jordanbyron/gb-proton-pack/docs/bargraph/Screenshot 2023-05-10 at 12.45.05 PM.png

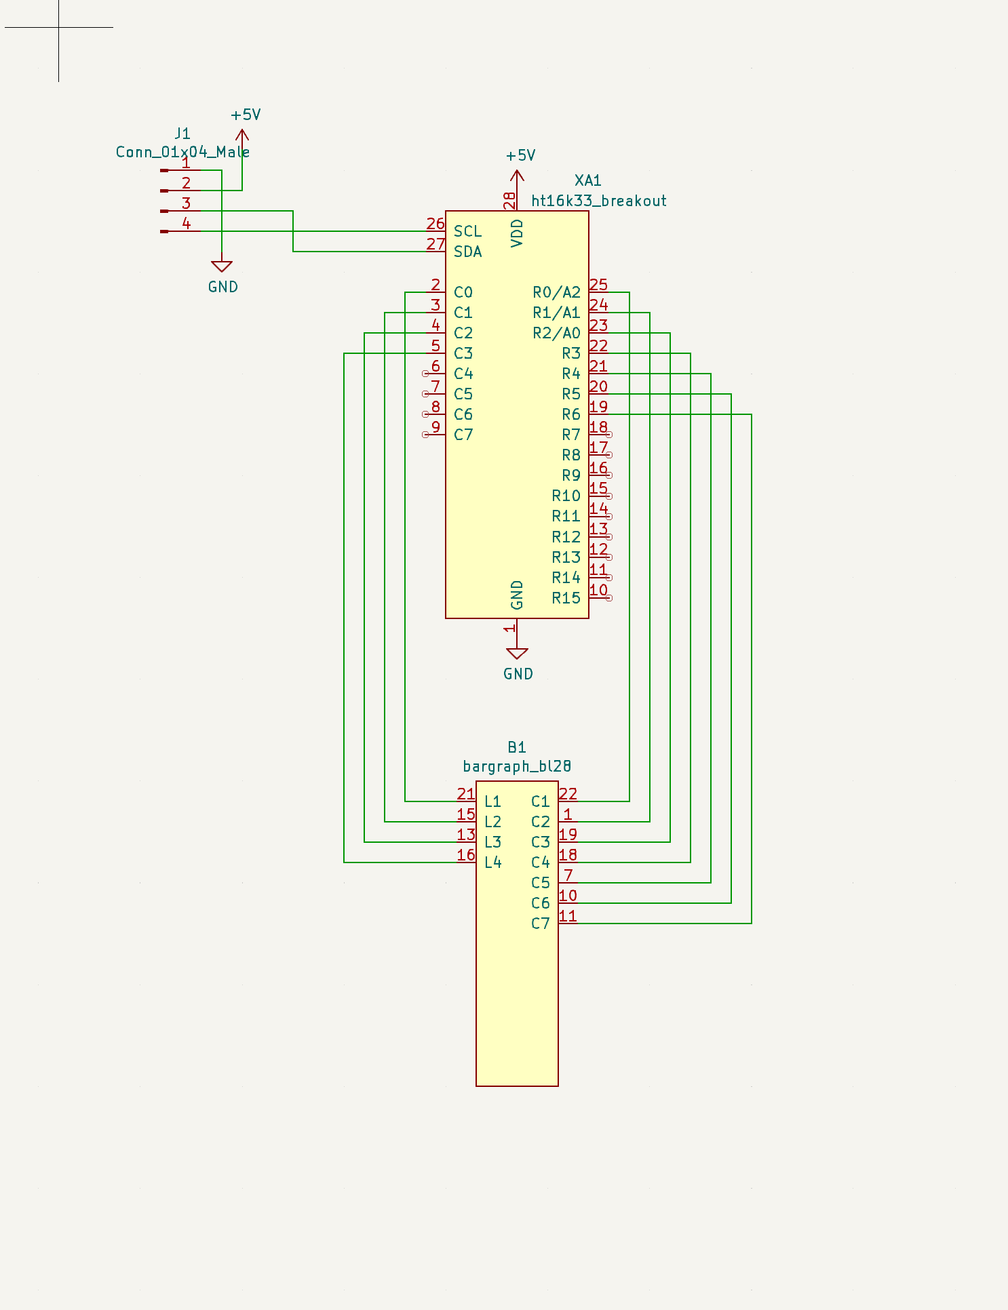
docs/bargraph/Screenshot 2023-05-10 at 12.45.05 PM.png
