jordanbyron/gb-proton-pack/(commit log)

2026-09-20 fix: Cycle smoke vape pen on / off
    [MainPack.ino]
2026-09-20 docs: Add AGENTS.md with compile verification steps (#2)
    The repo has no tests, so compiling both sketches with arduino-cli and
    comparing the flash / RAM size lines is the only behavior check. Write
    that down, along with the CRLF line-ending gotcha, and point CLAUDE.md
    at it so Claude Code loads the same file.
    Claude-Session: https://claude.ai/code/session_01Uyfv5omxBB1TRVGWwt6WKp
2026-09-20 refactor: Remove unused globals from wand sketch (#1)
    Delete the packMode and barGraphSequences enums (and their BG_MODES
    variable), which are declared but never referenced, and the bootStart
    timestamp, which is written on boot but never read.
    Verified by compiling for arduino:avr:nano before and after: no new
    warnings, dynamic memory unchanged (789 bytes), program storage down
    4 bytes from the dropped millis() call.
    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
2026-09-20 refactor: Make Lights own its blink state
    Move the two FireTimers and two blink flags that Lights.cpp kept as
    file-scope globals into private members, matching how the class
    already holds _lights, _pin and _numberOfPixels. The interval
    constants stay at file scope. Only one Lights instance exists, so the
    sequence of reads and writes is unchanged.
    Compiled for arduino:avr:nano before and after: RAM 789 bytes
    unchanged (same state, relocated). Flash 15900 -> 15956 bytes because
    AVR addresses members through the object pointer rather than fixed
    addresses.
    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
    [Lights.cpp, Lights.h]
2026-09-20 refactor: Make PowerCell own its animation state (#9)
2026-09-20 docs: Correct board to Arduino Uno in AGENTS.md (#10)
2026-09-20 refactor: Construct pack objects directly (#11)
    PowerCell and Cyclotron were built with a copy-init through an explicit
    constructor call, which is not valid C++ and only compiles under
    -fpermissive with a warning. Use direct initialisation, the form the
    wand sketch and the rest of this file already use.
    Compiled for arduino:avr:uno before and after: flash 17026 and RAM
    798 bytes both unchanged; the two "cannot call constructor directly"
    warnings are gone.
    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
2026-09-20 refactor: Make BarGraph own its display and animation state
    Move the HT16K33 matrix, the volume-display flag and timer, and the
    per-animation timers, keyframes, directions and flags that
    BarGraph.cpp kept as file-scope globals into private members. The four
    free resetXAnimation functions become private methods. The three
    animation constants stay at file scope.
    Only one BarGraph instance exists, so the sequence of reads and writes
    is unchanged. Every member carries the same initial value its global
    had.
    Compiled for arduino:avr:uno before and after: RAM 789 bytes
    unchanged (same state, relocated). Flash 15900 -> 16140 bytes from
    member addressing through the object pointer.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
    [BarGraph.cpp, BarGraph.h]
2026-09-20 fix: Clear lastMessage with a char, not a string literal (#13)
    [MainPack.ino]
2026-09-20 refactor: Drop undefined BarGraph declarations
    overload() and _cycleBootStep() are declared in BarGraph.h but have
    no definition in BarGraph.cpp and no callers, so any use would already
    have been a link error.
    Compiled for arduino:avr:uno: flash 16140 and RAM 789 bytes unchanged.
    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
    [BarGraph.h]
2026-10-26 fix: Confirm initial volume with the DFPlayer at boot
    The DFPlayer powers up at full volume (30) and drops commands until it
    has finished reading the SD card. setup() sent the volume once on a fixed
    1.5s delay, so on a slow boot the command was lost and the pack stayed at
    full volume. sfx.begin() always returns true, so it never caught this.
    Keep sending INITIAL_VOLUME and reading it back with currentVolume()
    until the player reports 15 (50%), giving up after 5s.
    Sizes (arduino:avr:uno):
    - MainPack: flash 17008 -> 18174, RAM 798 -> 1088 (query/parseFeedback
    are now linked in for the first time)
    - NeutrinoWand: flash 15906 -> 15906, RAM 789 -> 789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
2026-10-26 fix: Frame volume messages so line noise can't change the volume
    The pack treated every non-letter byte from the wand as a volume, so
    noise on the serial line (e.g. at power-up) could set a random volume.
    The wand now sends a 'v' marker before the volume byte. The pack only
    reads a volume after that marker, waiting for the second byte if it
    hasn't arrived yet, and discards any other non-letter byte.
    Both boards need to be flashed together; an old wand's bare volume
    bytes are now ignored by the pack.
    - MainPack: flash 17008 -> 17056, RAM 798 -> 798
    - NeutrinoWand: flash 15906 -> 15916, RAM 789 -> 789
    Claude-S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
2026-10-26 fix: Read the volume knob from a pin change interrupt
    The KY-040 was polled once per loop(), which takes at least 10ms plus
    NeoPixel and I2C time. A quick click could bring CLK low and back high
    between polls and be missed, and DT was read up to a loop after the CLK
    edge, so a click could count in the wrong direction and cancel the next.
    Decode both pins with a quadrature transition table from PCINT0
    (D9/D10 are on port B). A click counts once the knob is back at its
    detent (both pins high) after at least two valid transitions, so contact
    bounce cancels out and one transition lost while show() blocks
    interrupts doesn't drop it. run() takes the accumulated steps and fires
    onVolumeChange as b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
2026-10-27 feat: Run fan with smoke
2026-10-29 fix: Free RAM so the cyclotron strip can allocate its pixel buffer (#19)
    The cyclotron went dark after 763e9d0 raised the pack's static RAM from
    798 to 1088 bytes. Everything allocated at boot (two state machines,
    their transitions, and the two NeoPixel buffers) needs about 974 bytes
    of heap, and the cyclotron buffer is the last and largest request at
    323 bytes. With 960 bytes free it was refused, Adafruit_NeoPixel
    silently set the strip length to zero, and show() became a no-op. The
    power cell, allocated earlier and only 47 bytes, kept working.
    Two cuts:
    - Wrap the sketch's serial strings in F() so they live in flash.
    - Declare the cyclotron strip as the 28 jewel pixels only. The vent
    LE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
